manasXP/epicura-pcb/Unified_v1.3/Schematic_PDF/Unified_v1.3.pdf

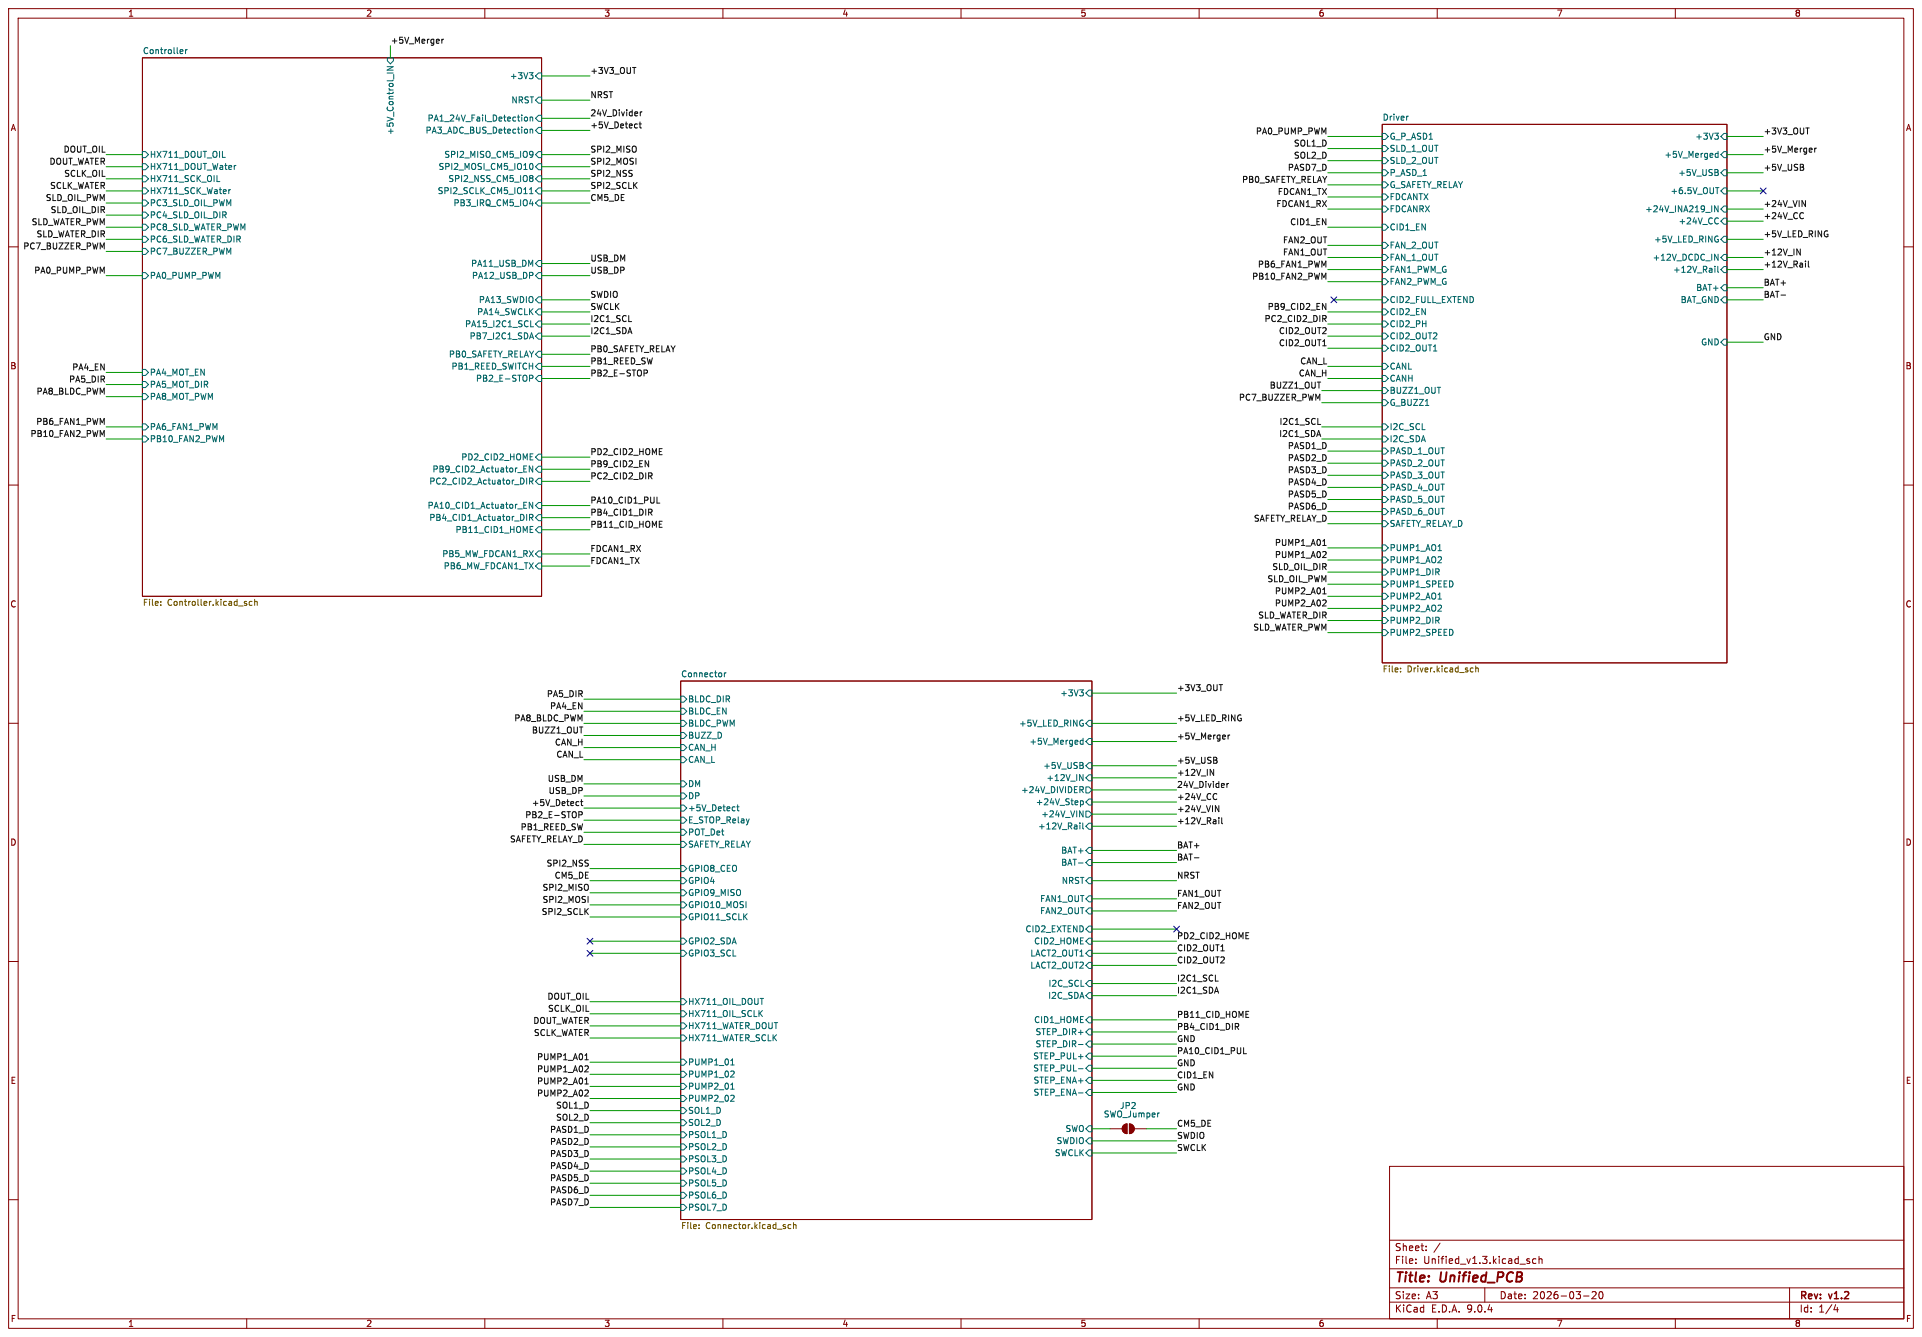
[picture p1: page 1]

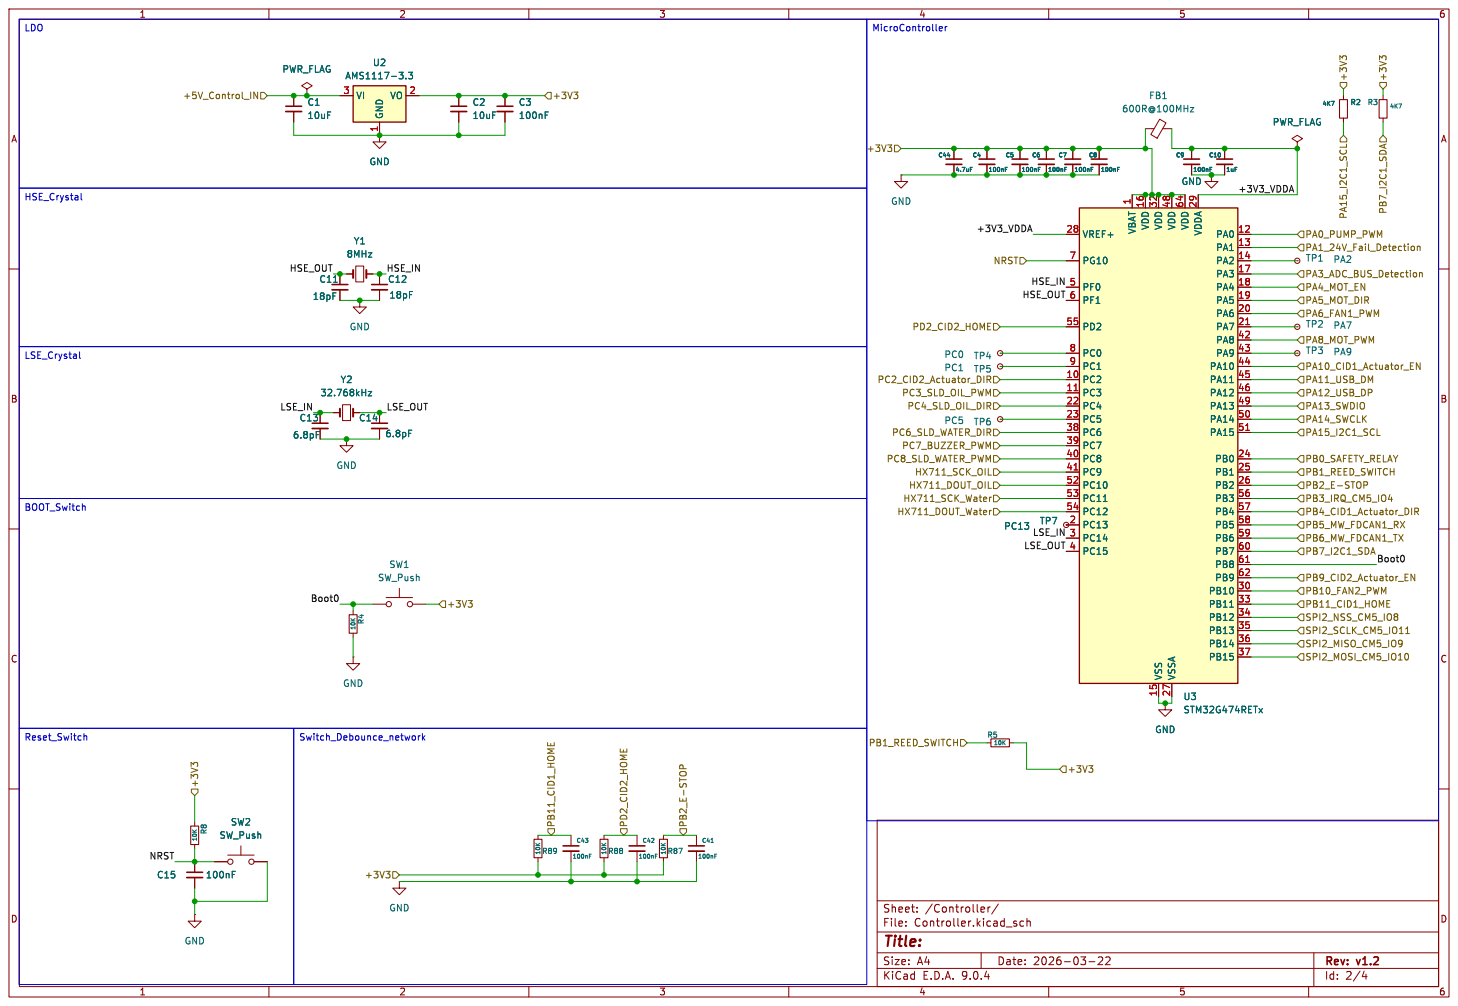
[picture p2: page 2]

Id: 2/4 Title: File: Controller.kicad_sch Sheet: /Controller/

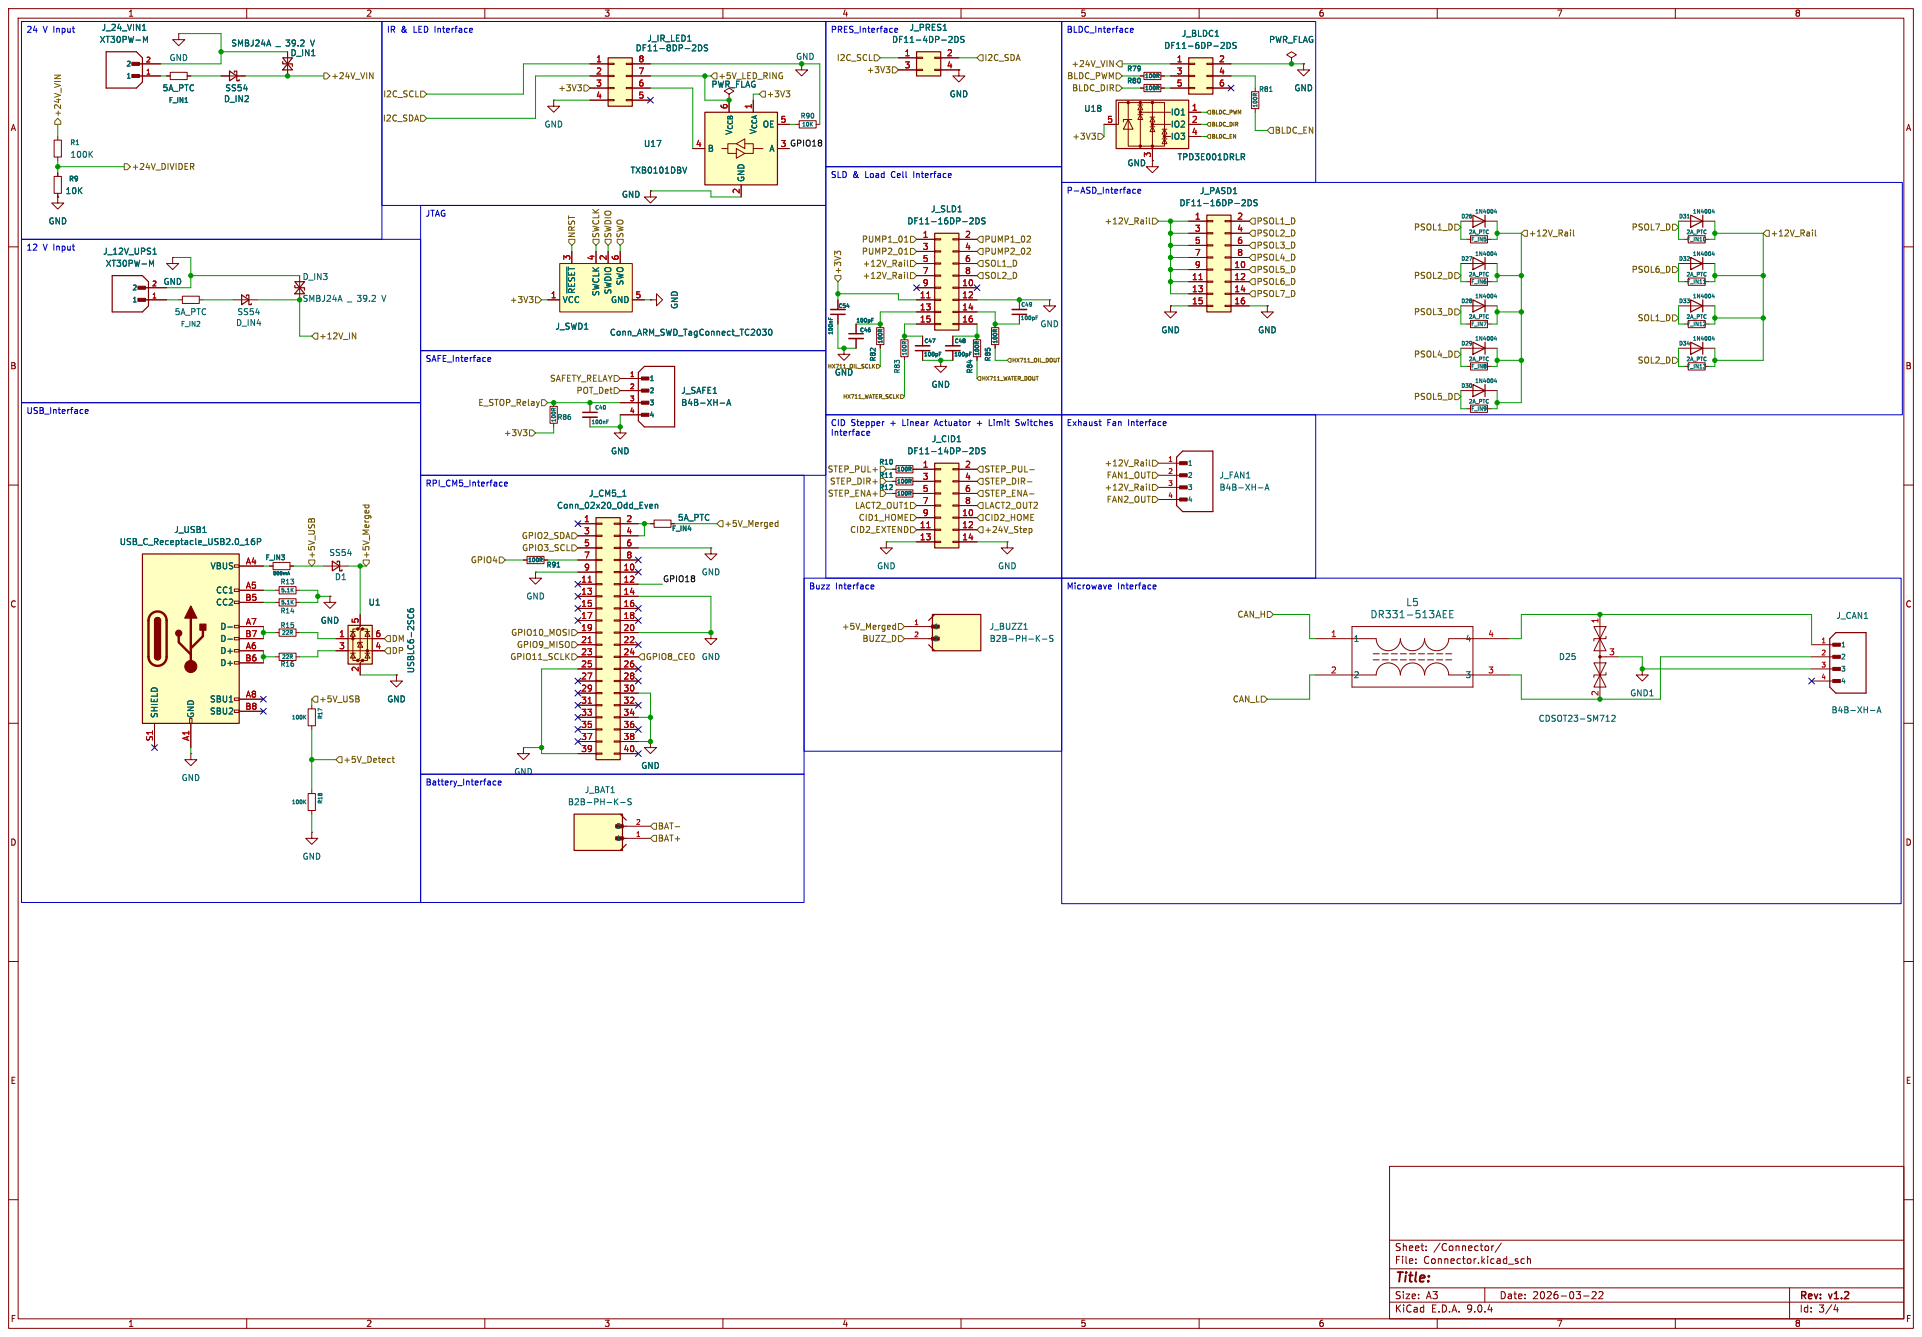
[picture p3: page 3]

SLD & Load Cell Interface

Id: 3/4 Title: File: Connector.kicad_sch Sheet: /Connector/

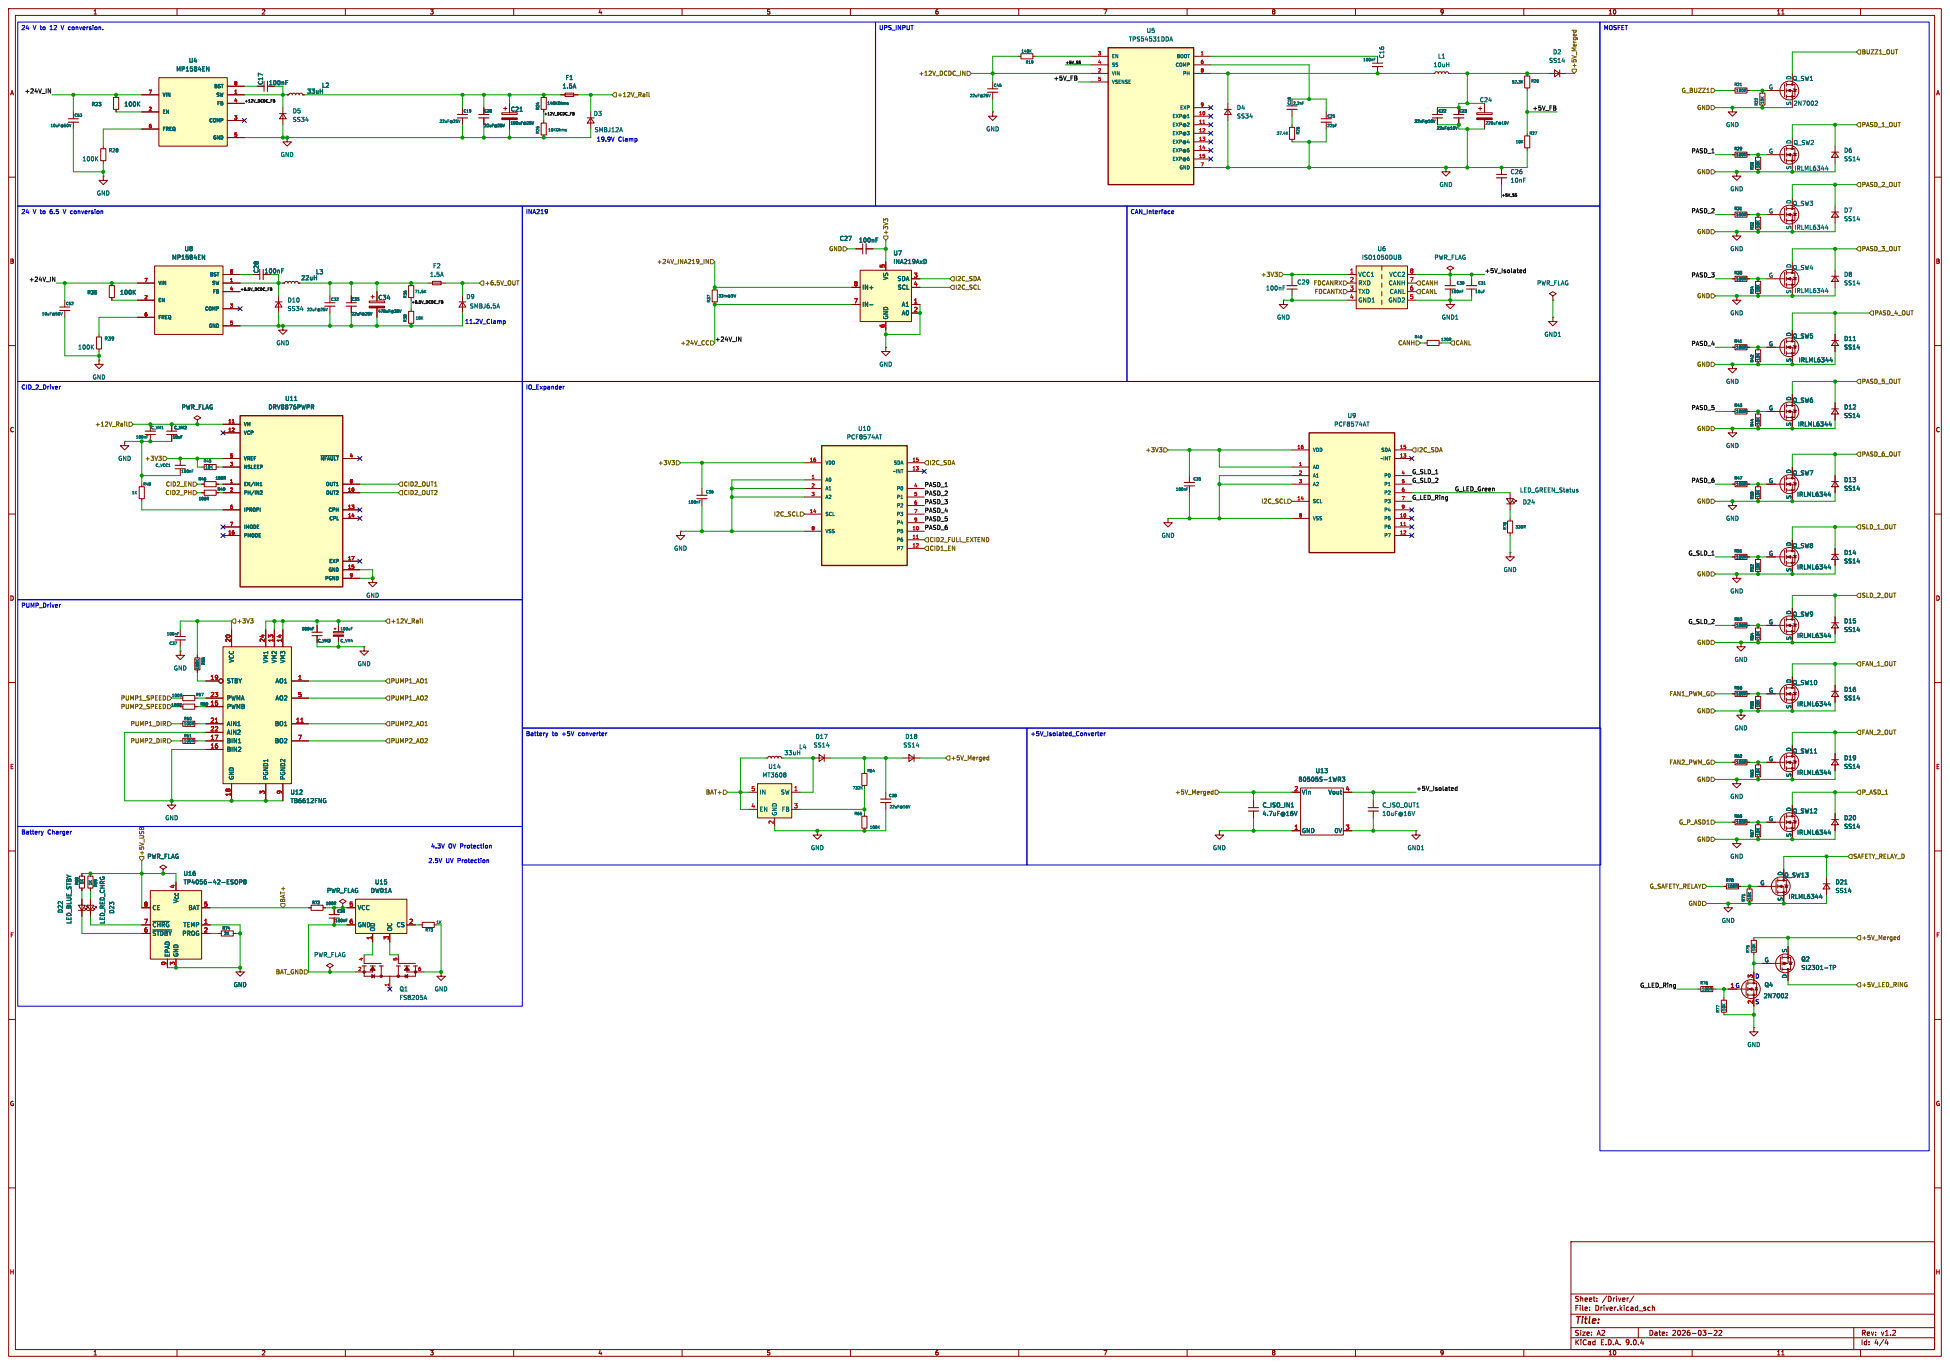
[picture p4: page 4]

3 BAT 5 TEMP 1 PROG 2 GND
