manasXP/epicura-pcb/Unified_v1.3/Unified_v1.3.kicad_pcb

## KiCad design Unified_v1.3/Unified_v1.3.kicad_pcb (2026-03-24)

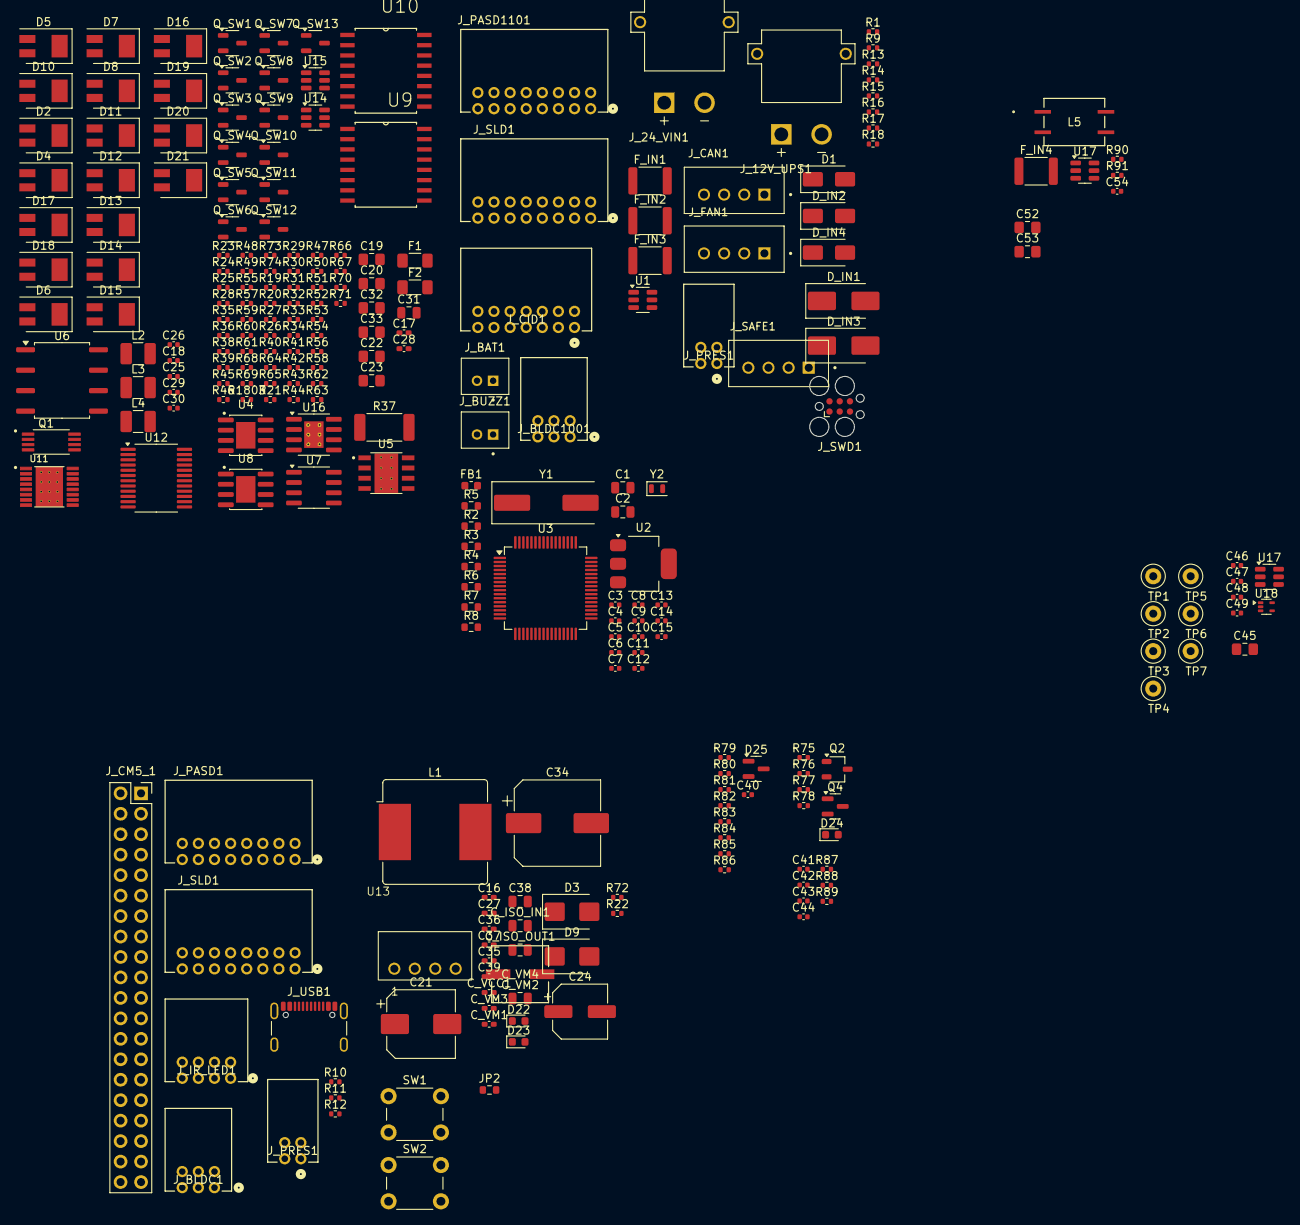
[picture p5: board Unified_v1.3.kicad_pcb from above]

Board: 4 copper layers, 259 parts (0 on the bottom side), 185 nets, no tracks yet.

Parts:
C1, C2, C31: 10uF; C_0805_2012Metric
C3, C4, C5, C6, C7, C8, C9, C15, C29, C30, C40, C41, C42, C43, C54: 100nF; C_0402_1005Metric
C10: 1uF; C_0402_1005Metric
C11, C12: 18pF; C_0402_1005Metric
C13, C14: 6.8pF; C_0402_1005Metric
C16, C17, C27, C28, C35, C36, C37, C39: 100nF; C_0402_1005Metric_Pad0.74x0.62mm_HandSolder
C18: 2.2nF; C_0402_1005Metric
C19, C20, C32, C33, C45: 22uF@25V; C_0805_2012Metric_Pad1.18x1.45mm_HandSolder
C21: 100uF@25V; CP_Elec_8x10
C22, C23: 22uF@10V; C_0805_2012Metric_Pad1.18x1.45mm_HandSolder
C24: 220uF@10V; CP_Elec_6.3x7.7
C25: 22pF; C_0402_1005Metric
C26: 10nF; C_0402_1005Metric
C34: 470uF@35V; CP_Elec_10x12.5
C38: 22uF@16V; C_0805_2012Metric
C44: 4.7uF; C_0402_1005Metric
C46, C47, C48, C49: 100pF; C_0402_1005Metric
C52, C53: 10uF@50V; C_0805_2012Metric_Pad1.18x1.45mm_HandSolder
C_ISO_IN1: 4.7uF@16V; C_0805_2012Metric
C_ISO_OUT1: 10uF@16V; C_0805_2012Metric
C_VCC1: 100nF; C_0402_1005Metric_Pad0.74x0.62mm_HandSolder
C_VM1, C_VM3: 100nF; C_0402_1005Metric_Pad0.74x0.62mm_HandSolder
C_VM2: 10uF; C_0805_2012Metric
C_VM4: 100uF; 100uF_Wruth_CAP_WCAP-ASLI_06p3X07p7_WRE
D1: SS54; D_SMA
D2, D6, D7, D8, D11, D12, D13, D14, D15, D16, D17, D18, D19, D20, D21: SS14; D_SMB_Modified
D3: SMBJ12A; D_SMB
D4, D5, D10: SS34; D_SMB_Modified
D9: SMBJ6.5A; D_SMB
D22: LED_BLUE_STBY; D_0603_1608Metric
D23: LED_RED_CHRG; D_0603_1608Metric
D24: LED_GREEN_Status; D_0603_1608Metric
D25: CDSOT23-SM712; SOT-23
D_IN1, D_IN3: SMBJ24A _ 39.2 V; D_SMB_Handsoldering
D_IN2, D_IN4: SS54; D_SMA
F1, F2: 1.5A; R_1206_3216Metric_Pad1.30x1.75mm_HandSolder
FB1: 600R@100MHz; L_0603_1608Metric
F_IN1, F_IN2, F_IN4: 5A_PTC; R_1812_4532Metric
F_IN3: 500mA; R_1812_4532Metric
JP2: SWO_Jumper; R_0603_1608Metric
J_12V_UPS1, J_24_VIN1: XT30PW-M; AMASS_XT30PW-M
J_BAT1: B2B-PH-K-S; JST_B2B-PH-K-S
J_BLDC1, J_BLDC1001: DF11-6DP-2DS; CON6_2X3_RF_DF11
J_BUZZ1: B2B-PH-K-S; JST_B2B-PH-K-S
J_CAN1: B4B-XH-A; JST_B4B-XH-A
J_CID1: DF11-14DP-2DS; CON14_2X7_RF_DF11_HIR
J_CM5_1: Conn_02x20_Odd_Even; PinSocket_2x20_P2.54mm_Vertical
J_FAN1: B4B-XH-A; JST_B4B-XH-A
J_IR_LED1: DF11-8DP-2DS; CON8_2X4_RF_DF11
J_PASD1, J_PASD1101: DF11-16DP-2DS; CON16_2X8_RF_DF11
J_PRES1, J_PRES1#2: DF11-4DP-2DS; CON4_2X2_RF_DF11_HIR
J_SAFE1: B4B-XH-A; JST_B4B-XH-A
J_SLD1, J_SLD1#2: DF11-16DP-2DS; CON16_2X8_RF_DF11
J_SWD1: Conn_ARM_SWD_TagConnect_TC2030; Tag-Connect_TC2030-IDC-FP_2x03_P1.27mm_Vertical
J_USB1: USB_C_Receptacle_USB2.0_16P; USB_C_Receptacle_GCT_USB4105-xx-A_16P_TopMnt_Horizontal
L1: 10uH; L_Bourns_SRR1208_12.7x12.7mm
L2, L4: 33uH; L_1210_3225Metric_Pad1.42x2.65mm_HandSolder
L3: 22uH; L_1210_3225Metric_Pad1.42x2.65mm_HandSolder
L5: DR331-513AEE; IND_DR331-513AEE_BRN
Q1: FS8205A; FS8205A_SOP65P640X120-8N
Q2: SI2301-TP; TSOT-23
Q4: 2N7002; SOT-23
Q_SW1: 2N7002; SOT-23-3
Q_SW2, Q_SW3, Q_SW4, Q_SW5, Q_SW6, Q_SW7, Q_SW8, Q_SW9, Q_SW10, Q_SW11, Q_SW12, Q_SW13: IRLML6344; SOT-23-3
R1, R17, R18, R23, R28, R35, R39, R55, R65: 100K; R_0402_1005Metric
R2, R3: 4K7; R_0603_1608Metric
R4, R5, R6, R7, R8: 10K; R_0603_1608Metric
R9, R22, R27, R30, R32, R34, R38, R42, R44, R45, R50, R52, R54, R58, R63, R67, R71, R75, R77, R87, R88, R89, R90: 10K; R_0402_1005Metric
R10, R11, R12, R21, R29, R31, R33, R41, R43, R46, R47, R49, R51, R53, R56, R57, R59, R60, R61, R62, R66, R70, R72, R76, R79, R80, R81, R82, R83, R84, R85, R86, R91: 100R; R_0402_1005Metric
R13, R14: 5.1K; R_0402_1005Metric
R15, R16: 22R; R_0402_1005Metric
R19: 140K; R_0402_1005Metric
R20: 52.3K; R_0402_1005Metric
R24: 140KOhms; R_0402_1005Metric
R25: 10KOhms; R_0402_1005Metric
R26: 37.4K; R_0402_1005Metric
R36: 71.5K; R_0402_1005Metric
R37: 33m@3W; R_2512_6332Metric_Pad1.40x3.35mm_HandSolder
R40: 120R; R_0402_1005Metric
R48, R68, R69, R73: 1K; R_0402_1005Metric
R64: 732K; R_0402_1005Metric
R74, R1803: 2K; R_0402_1005Metric
R78: 330R; R_0402_1005Metric
SW1, SW2: SW_Push; SW_PUSH_6mm
TP1: PA2; TestPoint_Loop_D1.80mm_Drill1.0mm_Beaded
TP2: PA7; TestPoint_Loop_D1.80mm_Drill1.0mm_Beaded
TP3: PA9; TestPoint_Loop_D1.80mm_Drill1.0mm_Beaded
TP4: PC0; TestPoint_Loop_D1.80mm_Drill1.0mm_Beaded
TP5: PC1; TestPoint_Loop_D1.80mm_Drill1.0mm_Beaded
TP6: PC5; TestPoint_Loop_D1.80mm_Drill1.0mm_Beaded
TP7: PC13; TestPoint_Loop_D1.80mm_Drill1.0mm_Beaded
U1, U17: USBLC6-2SC6; SOT-23-6
U2: AMS1117-3.3; SOT-223-3_TabPin2
U3: STM32G474RETx; LQFP-64_10x10mm_P0.5mm
U4, U8: MP1584EN; MP1584EN_SOIC127P600X170-9N
U5: TPS54531DDA; TPS54531DDA_VREG_LM5017MR_NOPB
U6: ISO1050DUB; SOP-8_6.62x9.15mm_P2.54mm
U7: INA219AxD; SOIC-8_3.9x4.9mm_P1.27mm
U9, U10: PCF8574AT; SOIC127P1032X265-16N_PCF8574AT
U11: DRV8876PWPR
U12: TB6612FNG; SSOP-24_5.3x8.2mm_P0.65mm
U13: B0505S-1WR3; B0505S-1WR3_Footprint
U14: MT3608; SOT-23-6
U15: DW01A; SOT-23-6
U16: TP4056-42-ESOP8; SOIC-8-1EP_3.9x4.9mm_P1.27mm_EP2.41x3.3mm_ThermalVias
U17#2: TXB0101DBV; SOT-23-6
U18: TPD3E001DRLR; SOT-553
Y1: 8MHz; Crystal_SMD_HC49-SD
Y2: 32.768kHz; Crystal_SMD_2012-2Pin_2.0x1.2mm

Connections:
/24V_Divider: R1.2, R9.1, U3.13 (PA1)
/+3V3_OUT: C2.1, C3.1, C4.1, C5.1, C6.1, C7.1, C8.1, C27.2, C29.2, C35.2, C36.2, C37.1, C44.1, C54.2, C_VCC1.2, FB1.1, J_IR_LED1.3, J_PRES1.3, J_PRES1#2.3, J_SLD1#2.11, J_SWD1.1 (VCC), R2.1, R3.1, R5.1, R6.1, R7.2, R8.2, R45.2, R55.2, R86.1, R87.1, R88.1, R89.1, SW1.2, U2.2 (VO), U3.1 (VBAT), U3.16 (VDD), U3.32 (VDD), U3.48 (VDD), U3.64 (VDD), U6.1 (VCC1), U7.5 (VS), U9.1 (A0), U9.16 (VDD), U10.16 (VDD), U11.5 (VREF), U12.20 (VCC), U17.5 (VBUS), U17#2.1 (V_{CCA}), U18.5
/+5V_Detect: R17.1, R18.2, U3.17 (PA3)
/+5V_LED_RING: J_IR_LED1.7, Q2.3 (D), U17#2.6 (V_{CCB})
/+5V_Merger: C1.1, C_ISO_IN1.1, D1.1 (K), D2.1 (K), D18.1 (K), F_IN4.1, J_BUZZ1.1, Q2.2 (S), R75.1, U1.5 (VBUS), U2.3 (VI), U13.2 (Vin)
/+5V_USB: D1.2 (A), F_IN3.1, R17.2, R68.2, R69.1, U16.4 (V_{CC}), U16.8 (CE)
/+12V_IN: C45.1, D_IN3.1 (A1), D_IN4.1 (K), R19.1, U5.2 (VIN)
/+12V_Rail: C_VM1.2, C_VM2.2, C_VM3.2, C_VM4.1, D3.1 (K), F1.2, J_FAN1.1, J_FAN1.3, J_PASD1.1, J_PASD1.3, J_PASD1.5, J_PASD1.7, J_PASD1.9, J_PASD1.11, J_PASD1.13, J_SLD1#2.5, J_SLD1#2.7, U11.11 (VM), U12.13 (VM2), U12.14 (VM3), U12.24 (VM1)
/+24V_CC: C52.1, C53.1, J_CID1.12, R23.1, R35.1, R37.2, U4.7 (VIN), U7.7 (IN-), U8.7 (VIN)
/+24V_VIN: D_IN1.1 (A1), D_IN2.1 (K), J_BLDC1.1, R1.1, R37.1, U7.8 (IN+)
/BAT+: J_BAT1.1, L4.1, R72.2, R1803.1, U14.4 (EN), U14.5 (IN), U16.5 (BAT)
/BAT-: C39.1, J_BAT1.2, Q1.2, Q1.3, U15.6 (GND)
/BUZZ1_OUT: J_BUZZ1.2, Q_SW1.3 (D)
/CAN_H: L5.1, R40.2, U6.7 (CANH)
/CAN_L: L5.2, R40.1, U6.6 (CANL)
/CID1_EN: R12.1, U10.12 (P7)
/CID2_OUT1: J_CID1.7, U11.8 (OUT1)
/CID2_OUT2: J_CID1.8, U11.10 (OUT2)
/CM5_DE: JP2.2 (B), R91.2, U3.56 (PB3)
/Connector/12V_IN: J_PASD1101.1, J_PASD1101.3, J_PASD1101.5, J_PASD1101.7, J_PASD1101.9, J_PASD1101.11, J_PASD1101.13, J_SLD1.5, J_SLD1.7
/Connector/GPIO18: J_CM5_1.12, U17#2.3 (A)
/Connector/SWO: JP2.1 (A), J_SWD1.6 (SWO)
/Controller/+3V3_VDDA: C9.1, C10.1, FB1.2, U3.28 (VREF+), U3.29 (VDDA)
/Controller/Boot0: R4.2, SW1.1, U3.61 (PB8)
/Controller/HSE_IN: C12.1, U3.5 (PF0), Y1.2
/Controller/HSE_OUT: C11.1, U3.6 (PF1), Y1.1
/Controller/LSE_IN: C13.1, U3.3 (PC14), Y2.1
/Controller/LSE_OUT: C14.1, U3.4 (PC15), Y2.2
/Controller/PB6_CID1_HOME: C43.1, R6.2, R89.2
/DOUT_OIL: J_SLD1.14, R85.1, U3.52 (PC10)
/DOUT_WATER: J_SLD1.16, R84.1, U3.54 (PC12)
/Driver/+5V_FB: R20.1, R27.2, U5.5 (VSENSE)
/Driver/+5V_Isolated: C30.2, C31.2, C_ISO_OUT1.1, U6.8 (VCC2), U13.4 (Vout)
/Driver/+5V_SS: C26.2, U5.4 (SS)
/Driver/+6.5V_DCDC_FB: R36.2, R38.1, U8.4 (FB)
/Driver/+6.5V_OUT: D9.1 (K), F2.2
/Driver/+12V_DCDC_FB: R24.2, R25.1, U4.4 (FB)
/Driver/G_LED_Green: D24.2 (A), U9.6 (P2)
/Driver/G_LED_Ring: R76.2, U9.7 (P3)
/Driver/G_SLD_1: R51.2, U9.4 (P0)
/Driver/G_SLD_2: R53.2, U9.5 (P1)
/Driver/PASD_1: R29.2, U10.4 (P0)
/Driver/PASD_2: R31.2, U10.5 (P1)
/Driver/PASD_3: R33.2, U10.6 (P2)
/Driver/PASD_4: R41.2, U10.7 (P3)
/Driver/PASD_5: R43.2, U10.9 (P4)
/Driver/PASD_6: R47.2, U10.10 (P5)
/FAN1_OUT: D16.1 (K), J_FAN1.2, Q_SW10.3 (D)
/FAN2_OUT: D19.1 (K), J_FAN1.4, Q_SW11.3 (D)
/FDCAN1_RX: U3.58 (PB5), U6.2 (RXD)
/FDCAN1_TX: U3.59 (PB6), U6.3 (TXD)
/I2C1_SCL: J_IR_LED1.1, J_PRES1.1, J_PRES1#2.1, R2.2, U3.51 (PA15), U7.4 (SCL), U9.14 (SCL), U10.14 (SCL), U17.1 (I/O1)
/I2C1_SDA: J_IR_LED1.2, J_PRES1.2, J_PRES1#2.2, R3.2, U3.60 (PB7), U7.3 (SDA), U9.15 (SDA), U10.15 (SDA), U17.3 (I/O2)
/NRST: C15.1, J_SWD1.3 (~RESET), R8.1, SW2.1, U3.7 (PG10)
/PA0_PUMP_PWM: R66.2, U3.12 (PA0)
/PA4_EN: J_BLDC1001.4, R81.1, U3.18 (PA4), U18.4 (IO3)
/PA5_DIR: J_BLDC1001.5, R80.1, U3.19 (PA5), U18.2 (IO2)
/PA8_BLDC_PWM: J_BLDC1001.3, R79.1, U3.42 (PA8), U18.1 (IO1)
/PA10_CID1_PUL: R10.1, U3.44 (PA10)
/PASD1_D: D6.1 (K), J_PASD1.2, J_PASD1101.2, Q_SW2.3 (D)
/PASD2_D: D7.1 (K), J_PASD1.4, J_PASD1101.4, Q_SW3.3 (D)
/PASD3_D: D8.1 (K), J_PASD1.6, J_PASD1101.6, Q_SW4.3 (D)
/PASD4_D: D11.1 (K), J_PASD1.8, J_PASD1101.8, Q_SW5.3 (D)
/PASD5_D: D12.1 (K), J_PASD1.10, J_PASD1101.10, Q_SW6.3 (D)
/PASD6_D: D13.1 (K), J_PASD1.12, J_PASD1101.12, Q_SW7.3 (D)
/PASD7_D: D20.1 (K), J_PASD1.14, J_PASD1101.14, Q_SW12.3 (D)
/PB0_SAFETY_RELAY: R70.2, U3.24 (PB0)
/PB1_REED_SW: J_SAFE1.2, R5.2, U3.25 (PB1)
/PB2_E-STOP: C40.1, C41.1, J_SAFE1.3, R86.2, R87.2, U3.26 (PB2)
/PB4_CID1_DIR: R11.1, U3.57 (PB4)
/PB6_FAN1_PWM: R56.2, U3.20 (PA6)
/PB9_CID2_EN: R46.2, U3.62 (PB9)
/PB10_FAN2_PWM: R62.2, U3.30 (PB10)
/PB11_CID_HOME: J_CID1.9, U3.33 (PB11)
/PC2_CID2_DIR: R49.1, U3.10 (PC2)
/PC7_Buzzer_PWM: R21.2, U3.39 (PC7)
/PD2_CID2_HOME: C42.1, J_CID1.10, R7.1, R88.2, U3.55 (PD2)
/PUMP1_A01: J_SLD1.1, J_SLD1#2.1, U12.1 (AO1), U12.2 (AO1)
/PUMP1_A02: J_SLD1.2, J_SLD1#2.2, U12.5 (AO2), U12.6 (AO2)
/PUMP2_A01: J_SLD1.3, J_SLD1#2.3, U12.11 (BO1), U12.12 (BO1)
/PUMP2_A02: J_SLD1.4, J_SLD1#2.4, U12.7 (BO2), U12.8 (BO2)
/SAFETY_RELAY_D: D21.1 (K), J_SAFE1.1, Q_SW13.3 (D)
/SCLK_OIL: J_SLD1.13, R82.1, U3.41 (PC9)
/SCLK_WATER: J_SLD1.15, R83.1, U3.53 (PC11)
/SLD_OIL_DIR: R60.2, U3.22 (PC4)
/SLD_OIL_PWM: R57.2, U3.11 (PC3)
/SLD_WATER_DIR: R61.2, U3.38 (PC6)
/SLD_WATER_PWM: R59.1, U3.40 (PC8)
/SOL1_D: D14.1 (K), J_SLD1.6, J_SLD1#2.6, Q_SW8.3 (D)
/SOL2_D: D15.1 (K), J_SLD1.8, J_SLD1#2.8, Q_SW9.3 (D)
/SPI2_MISO: J_CM5_1.21, U3.36 (PB14)
/SPI2_MOSI: J_CM5_1.19, U3.37 (PB15)
/SPI2_NSS: J_CM5_1.24, U3.34 (PB12)
/SPI2_SCLK: J_CM5_1.23, U3.35 (PB13)
/SWCLK: J_SWD1.4 (SWCLK), U3.50 (PA14)
/SWDIO: J_SWD1.2 (SWDIO), U3.49 (PA13)
/USB_DM: U1.6 (I/O1), U3.45 (PA11)
/USB_DP: U1.4 (I/O2), U3.46 (PA12)
GND: C1.2, C2.2, C3.2, C4.2, C5.2, C6.2, C7.2, C8.2, C9.2, C10.2, C11.2, C12.2, C13.2, C14.2, C15.2, C19.2, C20.2, C21.2, C22.2, C23.2, C24.2, C25.2, C26.1, C27.1, C29.1, C32.2, C33.2, C34.2, C35.1, C36.1, C37.2, C38.1, C40.2, C41.2, C42.2, C43.2, C44.2, C45.2, C46.2, C47.1, C48.1, C49.2, C52.2, C53.2, C54.1, C_ISO_IN1.2, C_VCC1.1, C_VM1.1, C_VM2.1, C_VM3.1, C_VM4.2, D3.2 (A), D4.2 (A), D5.2 (A), D6.2 (A), D7.2 (A), D8.2 (A), D9.2 (A), D10.2 (A), D11.2 (A), D12.2 (A), D13.2 (A), D14.2 (A), D15.2 (A), D16.2 (A), D19.2 (A), D20.2 (A), D21.2 (A), D_IN1.2 (A2), D_IN3.2 (A2), J_BLDC1.2, J_BLDC1001.2, J_CID1.2, J_CID1.4, J_CID1.6, J_CID1.13, J_CID1.14, J_CM5_1.6, J_CM5_1.9, J_CM5_1.14, J_CM5_1.20, J_CM5_1.25, J_CM5_1.30, J_CM5_1.34, J_CM5_1.38, J_CM5_1.39, J_IR_LED1.4, J_IR_LED1.8, J_PASD1.15, J_PASD1.16, J_PASD1101.15, J_PASD1101.16, J_PRES1.4, J_PRES1#2.4, J_SAFE1.4, J_SLD1.11, J_SLD1.12, J_SLD1#2.12, J_SWD1.5 (GND), J_USB1.A1 (GND), J_USB1.A12 (GND), J_USB1.B1 (GND), J_USB1.B12 (GND), Q1.6, Q1.7, Q4.2 (S), Q_SW1.2 (S), Q_SW2.2 (S), Q_SW3.2 (S), Q_SW4.2 (S), Q_SW5.2 (S), Q_SW6.2 (S), Q_SW7.2 (S), Q_SW8.2 (S), Q_SW9.2 (S), Q_SW10.2 (S), Q_SW11.2 (S), Q_SW12.2 (S), Q_SW13.2 (S), R4.1, R9.2, R13.2, R14.1, R18.1, R22.2, R25.2, R26.1, R27.1, R28.2, R30.2, R32.2, R34.2, R38.2, R39.2, R42.2, R44.2, R48.2, R50.2, R52.2, R54.2, R58.2, R63.2, R65.2, R67.2, R71.2, R73.2, R74.1, R77.2, R78.1, R90.2, SW2.2, U1.2 (GND), U2.1 (GND), U3.15 (VSS), U3.27 (VSSA), U3.31 (VSS), U3.47 (VSS), U3.63 (VSS), U4.5 (GND), U4.9 (GND), U5.7 (GND), U6.4 (GND1), U7.1 (A1), U7.2 (A0), U7.6 (GND), U8.5 (GND), U8.9 (GND), U9.2 (A1), U9.3 (A2), U9.8 (VSS), U10.1 (A0), U10.2 (A1), U10.3 (A2), U10.8 (VSS), U11.9 (PGND), U11.15 (GND), U12.3 (PGND1), U12.4 (PGND1), U12.9 (PGND2), U12.10 (PGND2), U12.16 (BIN2), U12.18 (GND), U12.22 (AIN2), U13.1 (GND), U14.2 (GND), U16.1 (TEMP), U16.3 (GND), U16.9 (EPAD), U17.2 (GND), U17#2.2 (GND), U18.3
GND1: C30.1, C31.1, C_ISO_OUT1.2, D25.3 (common), J_CAN1.3, U6.5 (GND2), U13.3 (0V)
unnamed: C18.2, R26.2
unnamed: C19.1, C20.1, C21.1, F1.1, L2.2, R24.1
unnamed: C32.1, C33.1, C34.1, F2.1, L3.2, R36.1
unnamed: C22.1, C23.1, C24.1, D2.2 (A), L1.2, R20.2
unnamed: C16.2, D4.1 (K), L1.1, U5.8 (PH)
unnamed: C17.2, D5.1 (K), L2.1, U4.1 (SW)
unnamed: C28.2, D10.1 (K), L3.1, U8.1 (SW)
unnamed: D17.2 (A), L4.2, U14.1 (SW)
unnamed: C38.2, D17.1 (K), D18.2 (A), R64.1
unnamed: D22.2 (A), R68.1
unnamed: D22.1 (K), U16.6 (~STDBY)
unnamed: D23.2 (A), R69.2
unnamed: D23.1 (K), U16.7 (~CHRG)
unnamed: D24.1 (K), R78.2
unnamed: D25.1 (A1), J_CAN1.1, L5.4
unnamed: D25.2 (A2), J_CAN1.2, L5.3
unnamed: D_IN2.2 (A), F_IN1.1
unnamed: D_IN4.2 (A), F_IN2.1
unnamed: F_IN3.2, J_USB1.A4 (VBUS), J_USB1.A9 (VBUS), J_USB1.B4 (VBUS), J_USB1.B9 (VBUS)
unnamed: J_BLDC1.3, R79.2
unnamed: J_BLDC1.4, R81.2
unnamed: J_BLDC1.5, R80.2
unnamed: J_CID1.1, R10.2
unnamed: J_CID1.3, R11.2
unnamed: J_CID1.5, R12.2
unnamed: F_IN4.2, J_CM5_1.2, J_CM5_1.4
unnamed: J_CM5_1.7, R91.1
unnamed: J_IR_LED1.6, U17#2.4 (B)
unnamed: C46.1, J_SLD1#2.13, R82.2
unnamed: C49.1, J_SLD1#2.14, R85.2
unnamed: C47.2, J_SLD1#2.15, R83.2
unnamed: C48.2, J_SLD1#2.16, R84.2
unnamed: J_USB1.A5 (CC1), R13.1
unnamed: J_USB1.B5 (CC2), R14.2
unnamed: J_USB1.A6 (D+), J_USB1.B6 (D+), R16.1
unnamed: J_USB1.A7 (D-), J_USB1.B7 (D-), R15.2
unnamed: Q2.1 (G), Q4.3 (D), R75.2
unnamed: Q4.1 (G), R76.1, R77.1
unnamed: Q_SW1.1 (G), R21.1, R22.1
unnamed: Q_SW2.1 (G), R29.1, R30.1
unnamed: Q_SW3.1 (G), R31.1, R32.1
unnamed: Q_SW4.1 (G), R33.1, R34.1
unnamed: Q_SW5.1 (G), R41.1, R42.1
unnamed: Q_SW6.1 (G), R43.1, R44.1
unnamed: Q_SW7.1 (G), R47.1, R50.1
unnamed: Q_SW8.1 (G), R51.1, R52.1
unnamed: Q_SW9.1 (G), R53.1, R54.1
unnamed: Q_SW10.1 (G), R56.1, R58.1
unnamed: Q_SW11.1 (G), R62.1, R63.1
unnamed: Q_SW12.1 (G), R66.1, R67.1
unnamed: Q_SW13.1 (G), R70.1, R71.1
unnamed: R15.1, U1.1 (I/O1)
unnamed: R16.2, U1.3 (I/O2)
unnamed: TP1.1, U3.14 (PA2)
unnamed: TP2.1, U3.21 (PA7)
unnamed: TP3.1, U3.43 (PA9)
unnamed: TP4.1, U3.8 (PC0)
unnamed: TP5.1, U3.9 (PC1)
unnamed: TP6.1, U3.23 (PC5)
unnamed: TP7.1, U3.2 (PC13)
unnamed: C17.1, U4.8 (BST)
unnamed: R23.2, U4.2 (EN)
unnamed: R28.1, U4.6 (FREQ)
unnamed: C16.1, U5.1 (BOOT)
unnamed: C18.1, C25.1, U5.6 (COMP)
unnamed: R19.2, U5.3 (EN)
unnamed: C28.1, U8.8 (BST)
unnamed: R35.2, U8.2 (EN)
unnamed: R39.1, U8.6 (FREQ)
unnamed: R46.1, U11.1 (EN/IN1)
unnamed: R48.1, U11.6 (IPROPI)
unnamed: R45.1, U11.3 (NSLEEP)
unnamed: R49.2, U11.2 (PH/IN2)
unnamed: R60.1, U12.21 (AIN1)
unnamed: R61.1, U12.17 (BIN1)
unnamed: R57.1, U12.23 (PWMA)
unnamed: R59.2, U12.15 (PWMB)
unnamed: R55.1, U12.19 (STBY)
unnamed: R64.2, R65.1, U14.3 (FB)
unnamed: R73.1, U15.2 (CS)
unnamed: Q1.5, U15.3 (OC)
unnamed: Q1.4, U15.1 (OD)
unnamed: C39.2, R72.1, U15.5 (VCC)
unnamed: R74.2, U16.2 (PROG)
unnamed: R90.1, U17#2.5 (OE)
