manasXP/epicura-pcb/(commit log)

2026-03-24 feat: add epicura docs repo as submodule
    Links the main epicura design/documentation repository as a submodule
    at docs/ for cross-referencing PCB design specs and schematics.
2026-03-24 feat: move PCB design docs from epicura repo
    Migrates all PCB documentation (unified design, design rules,
    schematic review, and archived controller/driver docs) to this
    dedicated PCB repo.
2026-03-24 refactor: remove epicura docs submodule
    No longer needed — PCB repo is self-contained.
2026-03-24 feat: add Unified v1.3 PCB design files
    Includes KiCad schematics (Connector, Controller, Driver), PCB layout,
    project files, BOM, schematic PDF, and modification review documents.
    [Connector.kicad_sch, Controller.kicad_sch, Driver.kicad_sch, Unified_v1.3.csv, Unified_v1.3.kicad_pcb, Unified_v1.3.kicad_sch]
2026-03-24 refactor: reorganize project structure and add CLAUDE.md
    Move schematic files into Schematic/ and PCB layout into PCB/
    subdirectories. Remove obsolete Modifications/ folder. Add CLAUDE.md
    project instructions and .claude/skills configuration.
    [Connector.kicad_sch, Controller.kicad_sch, Driver.kicad_sch, Unified_v1.3.kicad_pcb, Unified_v1.3.kicad_sch]
2026-03-24 fix: move schematic and PCB files back to project root
    KiCad requires the root schematic and PCB to be in the same directory
    as the .kicad_pro file. Subdirectories break project linking.
    [Connector.kicad_sch, Controller.kicad_sch, Driver.kicad_sch, Unified_v1.3.kicad_pcb, Unified_v1.3.kicad_sch]
2026-03-24 fix: correct feedback dividers, net label, and TEMP pin circuit
    - C-01: R36 71.5K → 14K (U8 MP1584EN Vout: 1.92V → 6.51V target 6.5V)
    - C-05: R26 37.4K → 52.3K (U5 TPS54531 Vout: 3.79V → 4.98V target 5V)
    - H-01: Rename root label PB6_FAN1_PWM → PA6_FAN1_PWM (was wrong pin ref)
    - H-06: Add R92 (100K) between TP4056 TEMP pin and GND (was shorted to
    PROG/GND junction, bypassing thermal protection entirely)
    [Driver.kicad_sch, Unified_v1.3.kicad_sch]
2026-03-24 feat: add project-local custom KiCad libraries
    Extract embedded symbols and footprints from schematic/PCB files into
    standalone library files. Create project-level sym-lib-table and
    fp-lib-table. Resolves 39 ERC warnings for missing libraries:
    - CONNECTOR_EPICURA (3 symbols, 9 footprints)
    - Drivers_Epicura_schematics (6 symbols)
    - Driver_Epicura_Footprints (6 footprints)
    - Common_Mode_Choke_Epicura (1 symbol, 1 footprint)
    - Epicura_Capacitor (1 footprint)
    ERC: 41 warnings → 2 (pre-existing, non-library)
